Empage/Digimato/README.md

Digimato
========

This repository contains the documentation and firmware of a self-built microcontrolled digital clock.
