Empage/Digimato/latex/document.tex

\documentclass[%
	pdftex,
	oneside,		% Einseitiger Druck.
	12pt,			% Schriftgroesse
	parskip=half,	% Halbe Zeile Abstand zwischen Absätzen.
	headsepline,	% Linie nach Kopfzeile.
	%footsepline,	% Linie vor Fusszeile.
	abstracton,	    % Abstract Überschriften
	ngerman,		% Translator
]{scrartcl}

% Zeichencodierung
\usepackage[utf8]{inputenc}
\usepackage[T1]{fontenc}
 
\newcommand{\pdftitel}{Konzeption und Entwicklung einer digitalen Funk-, LED-Uhr}
\newcommand{\autor}{Tobias Schöneberger, Matthis Hauschild}
\newcommand{\arbeit}{Studienarbeit}
%falls pdftitel = titel der Arbeit
\newcommand{\titel}{\pdftitel}
%bei unterschiedlichen Titeln
%\newcommand{\titel}{In der Regel haben wir einen zweizeiligen
% Bachelorthesistitel}
\newcommand{\kurs}{TIT10AID}
\newcommand{\datumAbgabe}{Juni 2013}
\newcommand{\abgabeort}{Stuttgart}
\newcommand{\studiengang}{Angewandte Informatik}
\newcommand{\dhbw}{Stuttgart}
\newcommand{\betreuer}{Prof. Dr. Karl Friedrich Gebhardt}
\newcommand{\gutachter}{Prof. Dr. Karl Friedrich Gebhardt}
\newcommand{\zeitraum}{12 Wochen}
\newcommand{\arbeitsart}{\arbeit}

%Seitengroesse
\usepackage{fullpage} 

%Zeilenumbruch und mehr
\usepackage[activate]{microtype}

% Zeilenabstand
\usepackage[onehalfspacing]{setspace}

% Index-Erstellung
%\usepackage{makeidx}

% Lokalisierung (neue deutsche Rechtschreibung)
\usepackage[ngerman]{babel}  
 
% Anführungszeichen 
\usepackage[babel,german=quotes]{csquotes}
%\usepackage[style=swiss]{csquotes}

% Spezielle Tabellenform fuer Deckblatt
\usepackage{longtable}
\setlength{\tabcolsep}{10pt} %Abstand zwischen Spalten
\renewcommand{\arraystretch}{1.5} %Zeilenabstand

% Grafiken
\usepackage{graphicx}

%Farben
\usepackage{color}
\definecolor{sh_comment}{rgb}{0.12, 0.38, 0.18 } %adjusted, in Eclipse: {0.25, 0.42, 0.30 } = #3F6A4D
\definecolor{sh_keyword}{rgb}{0.37, 0.08, 0.25}  % #5F1441
\definecolor{sh_string}{rgb}{0.06, 0.10, 0.98} % #101AF9

%\usepackage{fancyhdr}

\usepackage{bibgerm}
\usepackage{longtable}
% für textumflossene Grafiken
\usepackage{wrapfig} 

% Fussnoten
\usepackage[hang, multiple, stable]{footmisc}

% Verschiedene Schriftarten
%\usepackage{goudysans}
\usepackage{lmodern}
%\usepackage{libertine}
%\usepackage{palatino} 

% Hurenkinder und Schusterjungen verhindern
% http://projekte.dante.de/DanteFAQ/Silbentrennung
\clubpenalty=10000
\widowpenalty=10000
\displaywidowpenalty=10000

\newcommand{\degree}{\ensuremath{^\circ}}

% Titel, Autor und Datum
\title{\titel}
\author{\autor}
\date{\datum}

% PDF Einstellungen
\usepackage[%
	pdftitle={\pdftitel},
	pdfauthor={\autor},
	pdfsubject={\arbeit},
	pdfcreator={pdflatex, LaTeX with KOMA-Script},
	pdfpagemode=UseOutlines, % Beim Oeffnen Inhaltsverzeichnis anzeigen
	pdfdisplaydoctitle=true, % Dokumenttitel statt Dateiname anzeigen.
	pdfborder={0 0 0},
	pdflang=de % Sprache des Dokuments.
]{hyperref} 

 \usepackage{listings}
 \usepackage{courier}
 \lstset{
         basicstyle=\small\ttfamily, % Standardschrift
         numbers=left,               % Ort der Zeilennummern
         numberstyle=\tiny,          % Stil der Zeilennummern
         %stepnumber=2,               % Abstand zwischen den Zeilennummern
         numbersep=5pt,              % Abstand der Nummern zum Text
         tabsize=2,                  % Groesse von Tabs
         lineskip=-2pt,
         extendedchars=true,         %
         breaklines=true,            % Zeilen werden Umgebrochen
         keywordstyle=\color{sh_keyword}\bfseries,
            frame=b,         
 %        keywordstyle=[1]\textbf,    % Stil der Keywords
 %        keywordstyle=[2]\textbf,    %
 %        keywordstyle=[3]\textbf,    %
 %        keywordstyle=[4]\textbf,   \sqrt{\sqrt{}} %
         stringstyle=\color{sh_string}\ttfamily, % Farbe der String
         commentstyle=\color{sh_comment},
         showspaces=false,           % Leerzeichen anzeigen ?
         showtabs=false,             % Tabs anzeigen ?
         xleftmargin=17pt,
         framexleftmargin=17pt,
         framexrightmargin=5pt,
         framexbottommargin=4pt,
         %backgroundcolor=\color{lightgray},
         showstringspaces=false      % Leerzeichen in Strings anzeigen ?        
 }
 \lstloadlanguages{% Check Dokumentation for further languages ...
         %[Visual]Basic
         %Pascal
         C
         %C++
         %XML
         %HTML
         %Java
 }
\usepackage{caption}
\DeclareCaptionFont{white}{\color{white}}
\DeclareCaptionFormat{listing}{\colorbox[cmyk]{0.43, 0.35, 0.35,0.01}{\parbox{\textwidth}{\hspace{15pt}#1#2#3}}}
\captionsetup[lstlisting]{format=listing,labelfont=white,textfont=white, singlelinecheck=false, margin=0pt, font={bf,footnotesize}}

\begin{document}
	\renewcommand{\figurename}{Abb.}
	% Deckblatt
	\begin{spacing}{1}
		\input{deckblatt}
	\end{spacing}
	\newpage

	% Sperrvermerk
	\renewcommand{\thepage}{\Roman{page}} 
	\setcounter{page}{1}

	% Erklärung
	\input{erklaerung}
	\newpage
	
	\tableofcontents
	\newpage 
	
	\renewcommand{\thepage}{\arabic{page}}
	\setcounter{page}{1}
	 
	\input{einleitung.tex} 
	\input{anforderungen.tex}
	\input{grundlagen.tex}
	\input{komponenten.tex}
	\input{gesamtsystem.tex}
	\input{resume.tex}
%
    \newpage
    \bibliography{Literatur/stud}
    \bibliographystyle{geralpha}
%
    \newpage
    \appendix
    \input{appendix.tex}
\end{document}    
%
% Einleitung
% -Motivation
% -Umfang
% Anforderungen
% Technische Grundlagen
% - DCF77
% - LED Matrix
% - PWM
% Betrachtung der Komponenten
% - Mikrocontroller
% - DCF77 Empfangsmodul
% - LED Matrix
% - Helligkeitssensor
% - Temperatursensor
% - Infrarotempfänger
% Betrachtung des Gesamtsystems
% - Gehäuse
% Zusammenfassung
% -Evaluation
% -Weiterentwicklungsmoeglichkeiten
% -Fazit
% - Kosten

% NANANNANAN Matt\cite{cite1} Tobi\cite{cite2}
% 
% Uberblick gesamtsystem
% - Anfordungen an die Uhr
%  - elementar
%   - Zeitempfang
%   - Anzeigen der Zeit
%  - erweitert
%   - Datumsanzeige
%   - Wecker
%   - Helligkeitsanpassung
%   - geschaltet steckdose
%   - infrarotempfang
%   - temperatursensor
%   - Updatefaehigkeit
%   - Uhrzeit einstellen
%   
% -Betrachtung der einzelenen Elemente
%  - minimal
%  - erweitert
% -Display (LED Matrix)
%  - Prinzip
%  - Moeglichkeiten zur umsetzung
%  - vor und nachteile der Moeglichen
% - Zeitempfang
%  - DCF77 vs. GPS vs. England sender
%    GPS genauer aber teuerer, indoorempfang gut?
%  - DCF77 im Detail
%  - vergleich von verschieden empfangsmodulen
%  - vergleich von verschieden methoden zur auswertung
% - Mikrocontroller
%  - Warum mikrocontroller? und nicht fertiger baustein?
%  - ATmega vs. z.B. Cortex-m3 vs 
%  - Pro:
%   - einfache Programmierung
%   - guenstig
%   - einzeln verfuegbar
%   - DIP
%   - geringer stromverbrauch
%   - viele IO Pins
%   - viel verfuegbarer code
% 
%  
% - Zusatzmodule
%  - Temperatur
%   1 wire bus sensor um pins zu sparen und adc muss dann nicht umgeschaltet werden
%  - Helligkeit und dimmen
%   Lichtabhaeniger Widerstand an A/D Wandler und LED PWM
%  - Wecker
%   Lautsprecher + Weckzeit im EEPROM
%  - Steckdosenmodul
%   Relais mit verstaerkendem transistor/fet
%  - Infrarotmodul
%   Empfang und dekodierung von Infrarotsignalen von Fernbedienungen zur einstellung der Weckzeit
%  -
