Empage/Digimato/latex/deckblatt.tex

\begin{titlepage}
	\begin{longtable}{p{.4\textwidth} p{.4\textwidth}}
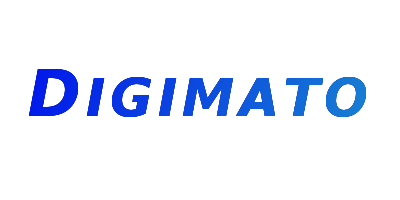
[picture p24: latex/images/logo.png]
	  {} & 
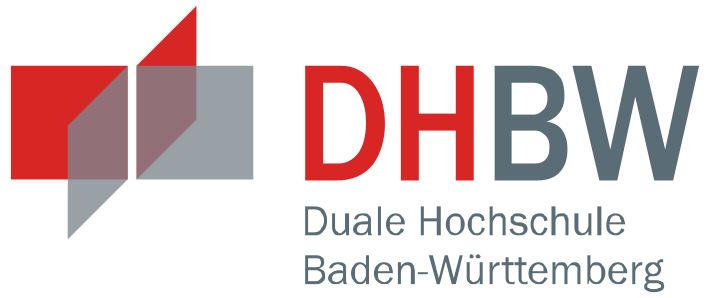
[picture p25: latex/images/dhbw.png]
	  {}
	\end{longtable}
	\enlargethispage{25mm}
	\begin{center}
	  \vspace*{18mm}	{\LARGE\bf \titel }\\
	  \vspace*{18mm}	{\large\bf \arbeit}\\
	  \vspace*{18mm}	\studiengang\\
	  \vspace*{3mm} 	an der Dualen Hochschule Baden-Württemberg \dhbw\\
	  \vspace*{18mm}	von\\
	  \vspace*{3mm} 	{\large\bf \autor}\\
	  \vspace*{18mm}	\datumAbgabe\\
	\end{center}
	\vfill
	\begin{spacing}{1.2}
	\begin{tabbing}
		mmmmmmmmmmmmmmmmmmmmmmmmmm     \= \kill
		\textbf{Abgabe}  \>  10.06.2013\\
		\textbf{Kurs}  				   \>  \kurs\\
		\textbf{Betreuer}              \>  \betreuer\\
		\textbf{Gutachter}             \>  \gutachter
	\end{tabbing}
	\end{spacing}
\end{titlepage}
