Empage/Digimato/latex/erklaerung.tex

\thispagestyle{empty}

\section*{Erklärung}
% http://www.se.dhbw-mannheim.de/fileadmin/ms/wi/dl_swm/dhbw-ma-wi-organisation-bewertung-bachelorarbeit-v2-00.pdf
\vspace*{2em}

Wir erklären hiermit ehrenwörtlich: \\
\begin{enumerate}
\item dass wir unsere {\arbeitsart} mit dem Thema
{\itshape \titel } ohne fremde Hilfe angefertigt haben;
\item dass wir die Übernahme wörtlicher Zitate aus der Literatur sowie die
Verwendung der Gedanken anderer Autoren an den entsprechenden Stellen innerhalb
der Arbeit gekennzeichnet haben;
\item dass wir unsere {\arbeitsart} bei keiner anderen Prüfung vorgelegt habe;
\item dass die eingereichte elektronische Fassung exakt mit der eingereichten schriftlichen Fassung
übereinstimmt.
\end{enumerate}

Wir sind uns bewusst, dass eine falsche Erklärung rechtliche Folgen haben wird.

\vspace{3em}

\abgabeort, \datumAbgabe
\vspace{6em}

\begin{tabular}[h]{p{5cm} p{2cm} p{5cm}}
  \hline
	Matthis Hauschild & &Tobias Schöneberger \\
\end{tabular}
