Empage/Digimato/latex/schaltplan 2.pptx

+5V

Reihe 1..8

1

Reihe 9..16

R 17

2

TPIC 6B595

8

TPIC 6B595

8

SER_IN

ATmega
32

7

SER_IN

SER_OUT

SER_OUT

Spalte 1..7

2

R_CK + SR_CK
