Empage/Digimato/doc/AVR pinbelegung neu ohne IR.pdf

Tabelle1

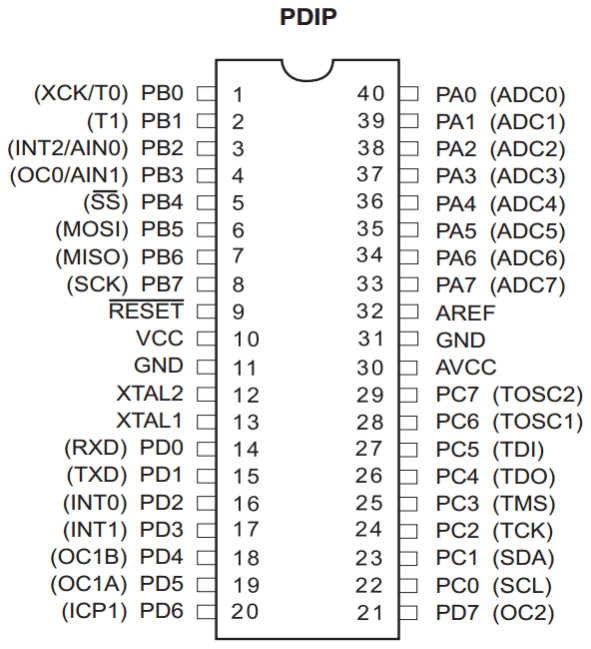
[picture p26: figure]

14,745600 MHz

Debug Pin | PB0 | PA0
Debug LED | PB1 | PA1
PB2 | PA2 | Taster3 (rot)
PB3 | PA3 | Taster4 (rot)
SR: RCK | PA4
SR: SER_IN | PB5(MOSI) | PA5
PB6(MISO) | PA6
SR: SRCK | PB7(SCK) | PA7
TPIC6B595N | RESET | AREF
VCC | GND
GND | AVCC
XTAL2 | PC7
XTAL1 | PC6
MOSF(1) | PD0 | PC5
MOSF(2) | PD1 | PC4
MOSF(3) | PD2 | PC3
MOSF(4) | PD3 | PC2
MOSF(5) | PD4 | PC1
MOSF(6) | PD5 | PC0
MOSF(7) | PD6 | PD7

Taster1 (schwarz)
Taster2 (schwarz)
DCF77-Modul
PB4(SS) | Taster5 (blau) Taster6 (blau)
Schieberegister | Lichtsensor
Quarz | Lagesensor 0
Quarz | Lagesensor 1
| Lagesensor 2
| Lagesensor 3

Lautsprecher
17 Reihe Led
