Empage/Digimato/doc/fresh images/unterseite_drahtgitter.jpg

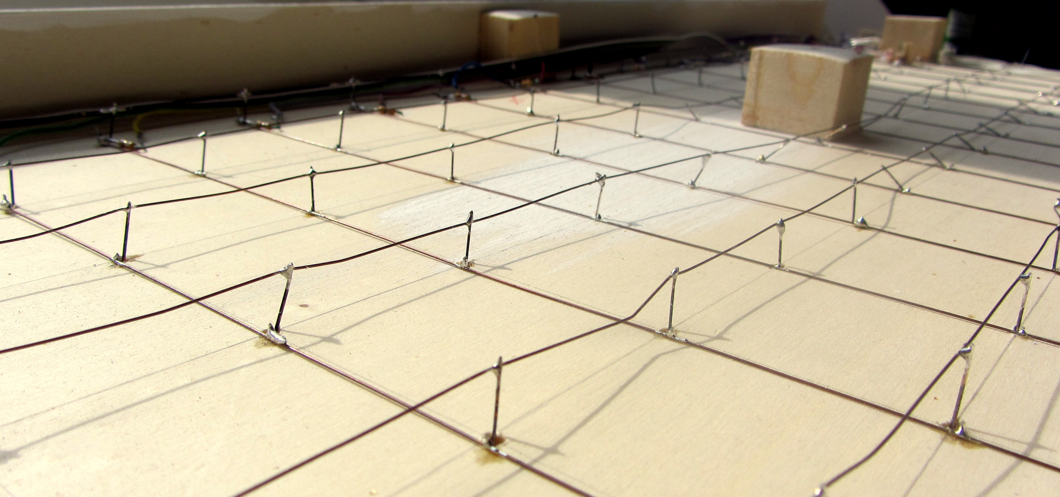
doc/fresh images/unterseite_drahtgitter.jpg
