Empage/Digimato/doc/raw images/2012-11-22 17.52.00.jpg

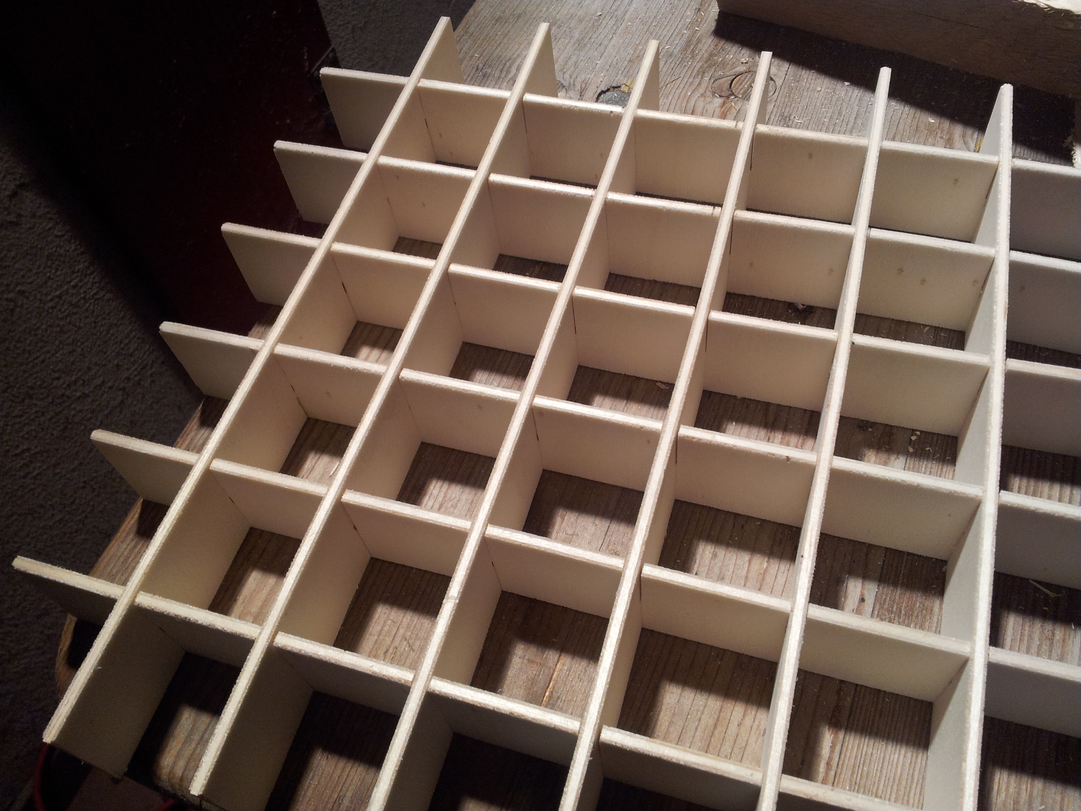
doc/raw images/2012-11-22 17.52.00.jpg
