Empage/Digimato/doc/raw images/2012-11-29 11.09.01.jpg

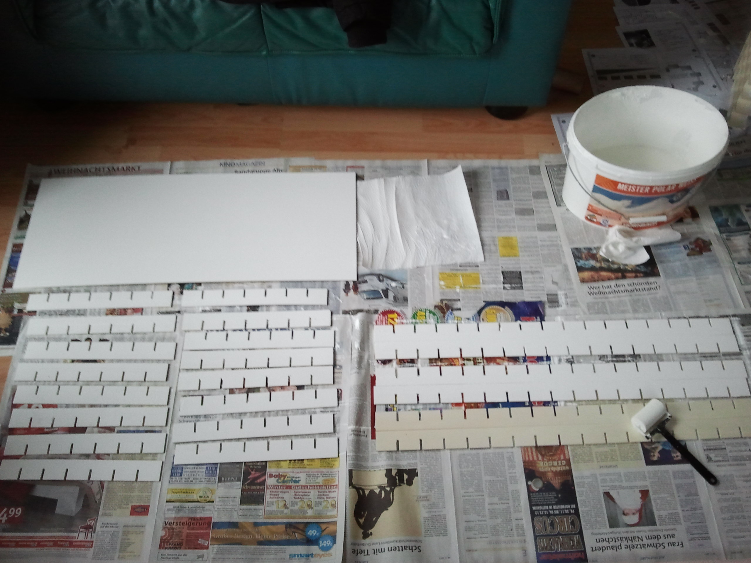
doc/raw images/2012-11-29 11.09.01.jpg
