Empage/Digimato/doc/raw images/2013-01-19 23.54.27.jpg

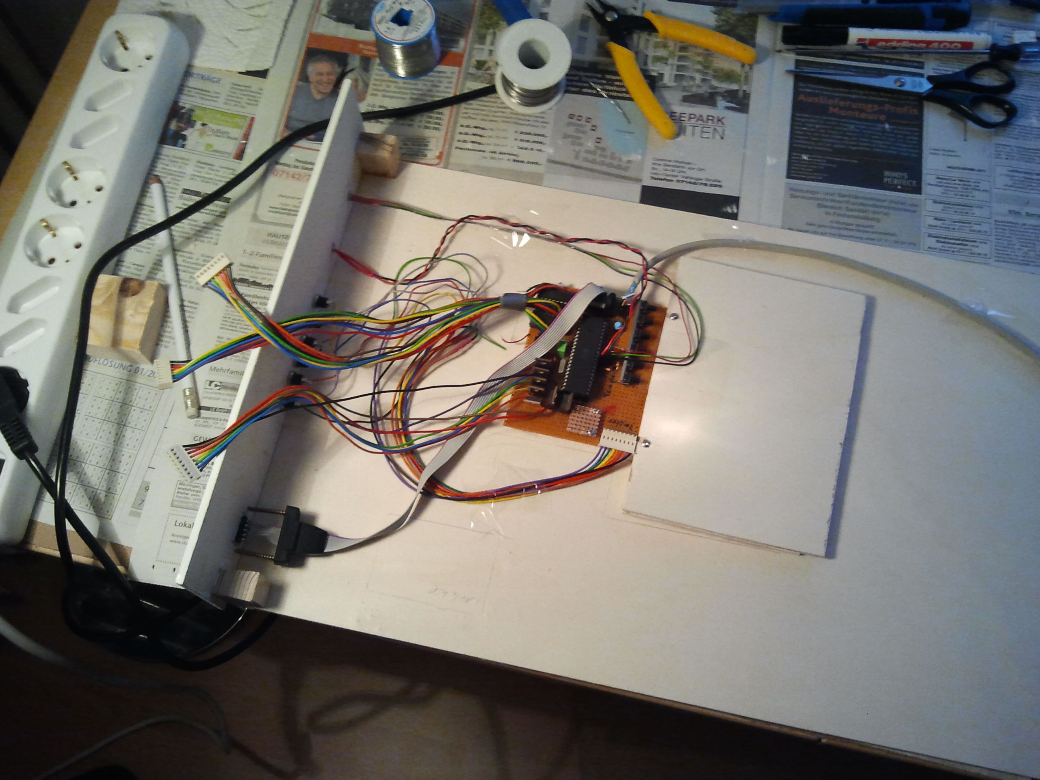
doc/raw images/2013-01-19 23.54.27.jpg
