Empage/Digimato/doc/raw images/2013-01-19 23.55.18.jpg

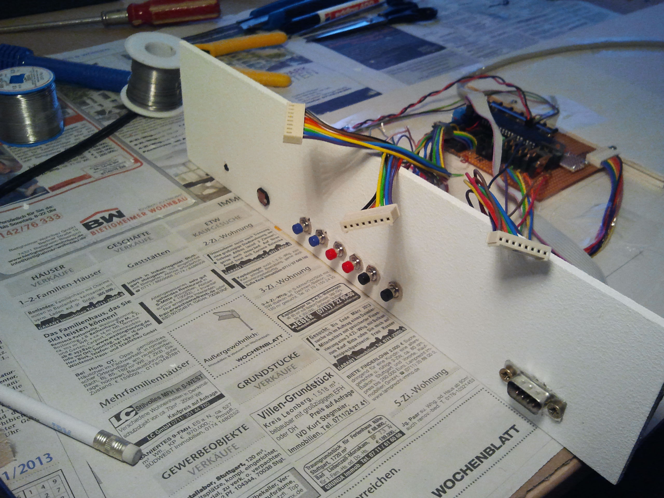
doc/raw images/2013-01-19 23.55.18.jpg
