Empage/Digimato/doc/raw images/2013-01-20 00.01.10.jpg

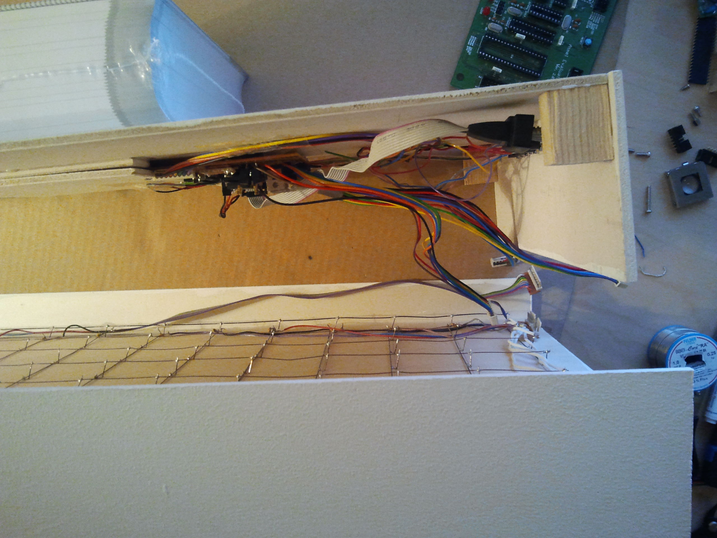
doc/raw images/2013-01-20 00.01.10.jpg
