Empage/Digimato/doc/raw images/2013-01-20 00.05.20.jpg

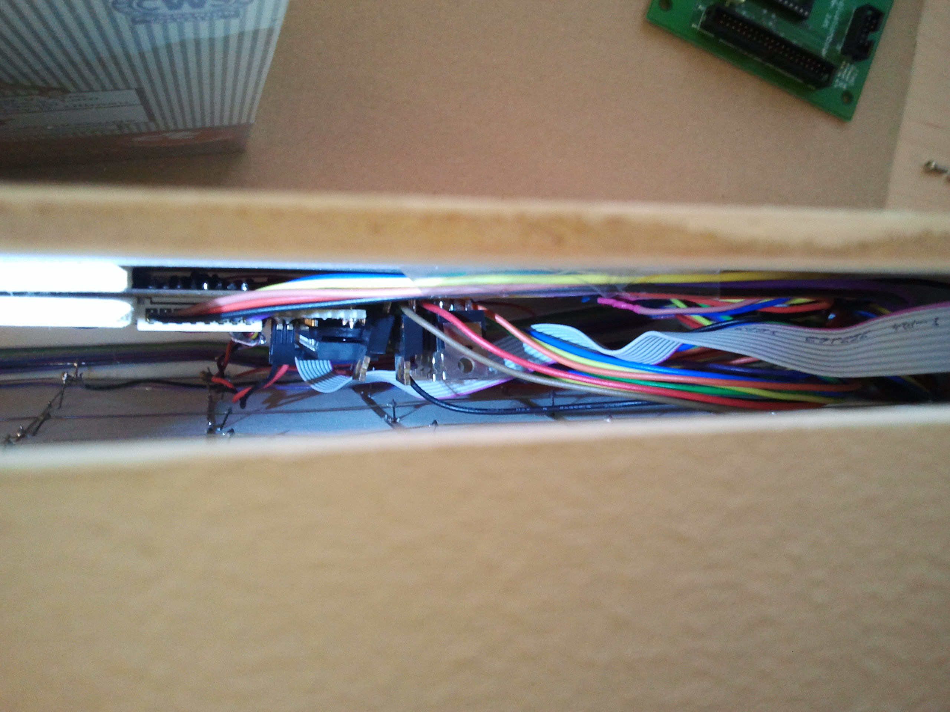
doc/raw images/2013-01-20 00.05.20.jpg
