Empage/Digimato/doc/raw images/2013-01-20 00.16.05.jpg

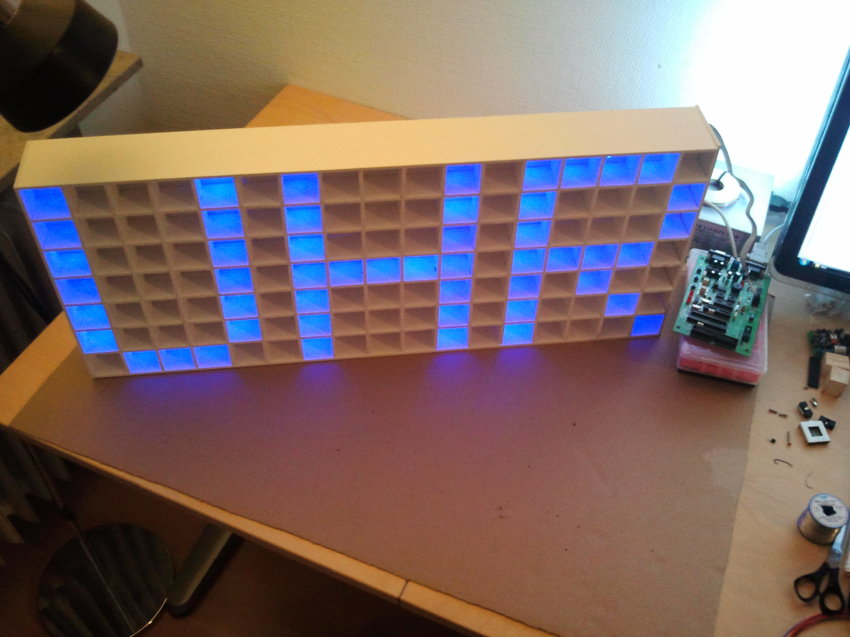
doc/raw images/2013-01-20 00.16.05.jpg
