Empage/Digimato/doc/raw images/IMG_1525.JPG

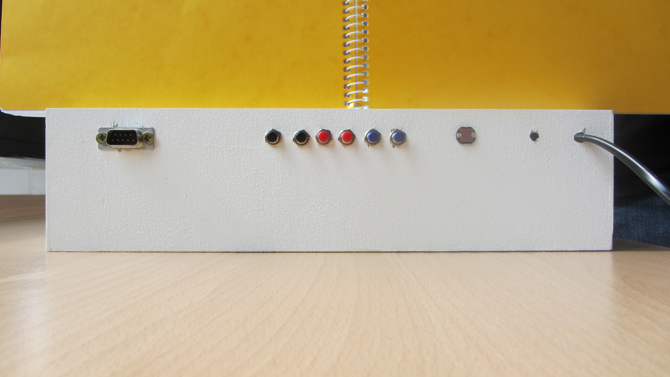
doc/raw images/IMG_1525.JPG
