Empage/Digimato/doc/raw images/IMG_1526.JPG

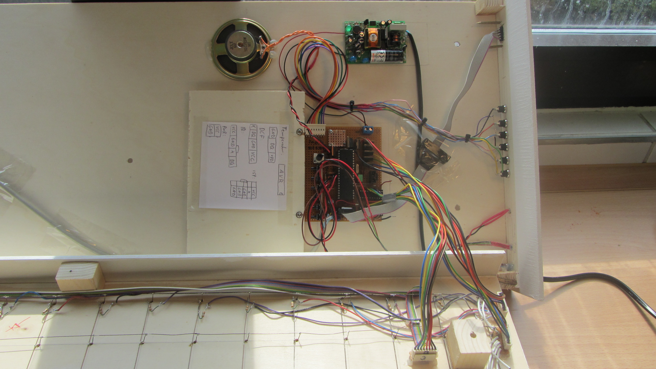
doc/raw images/IMG_1526.JPG
