Empage/Digimato/doc/raw images/IMG_1527.JPG

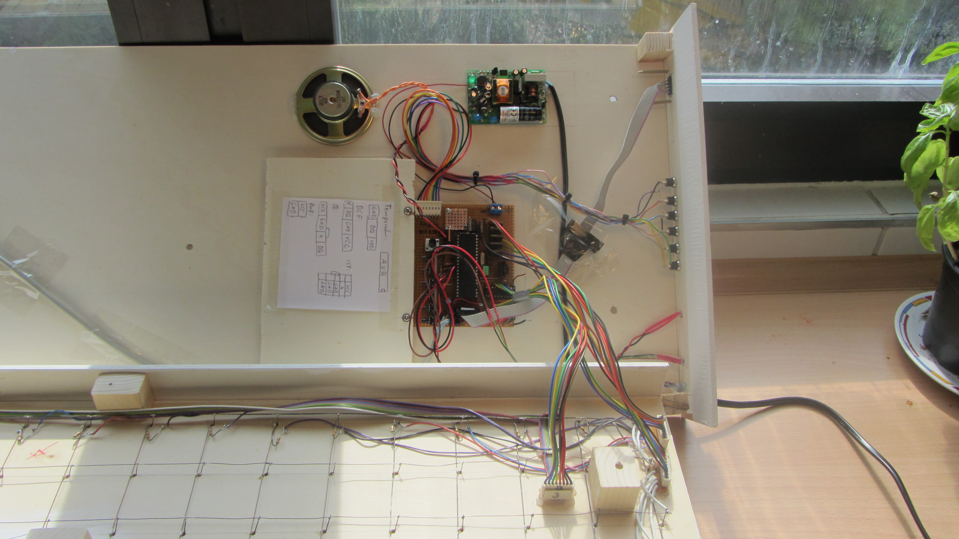
doc/raw images/IMG_1527.JPG
