Empage/Digimato/doc/raw images/IMG_1528.JPG

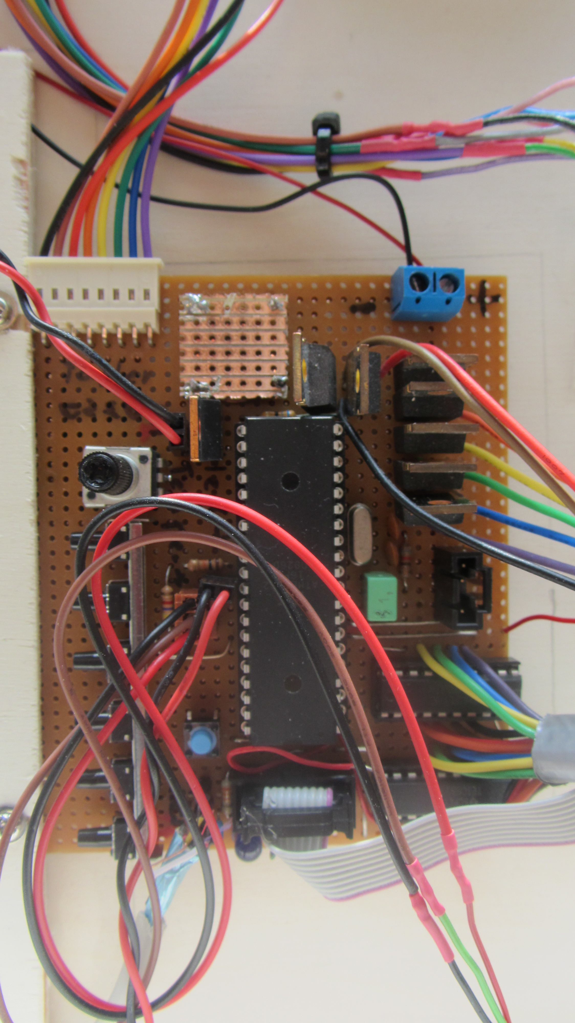
doc/raw images/IMG_1528.JPG
