Empage/Digimato/doc/raw images/IMG_1529.JPG

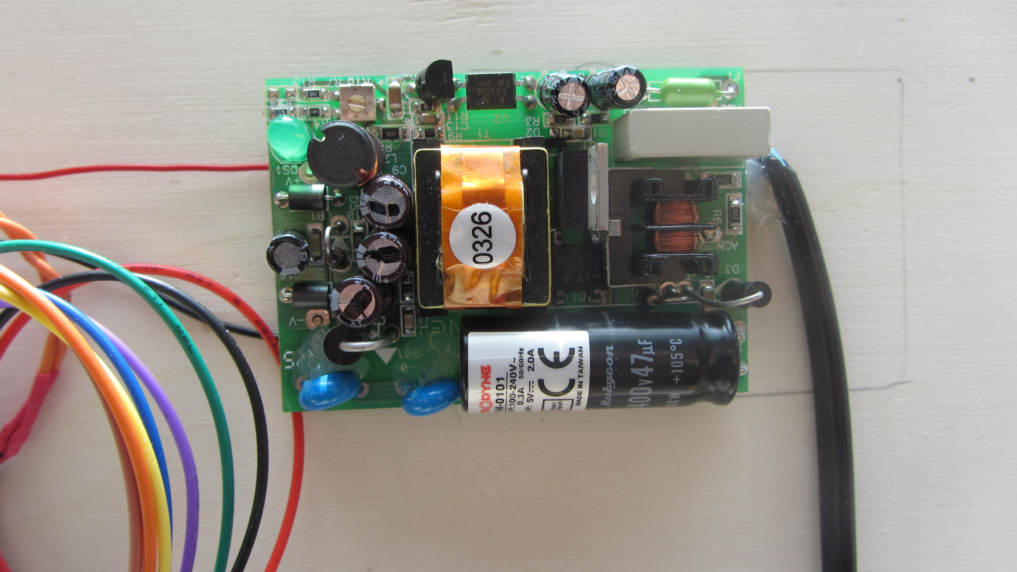
doc/raw images/IMG_1529.JPG
