Empage/Digimato/doc/raw images/IMG_1531.JPG

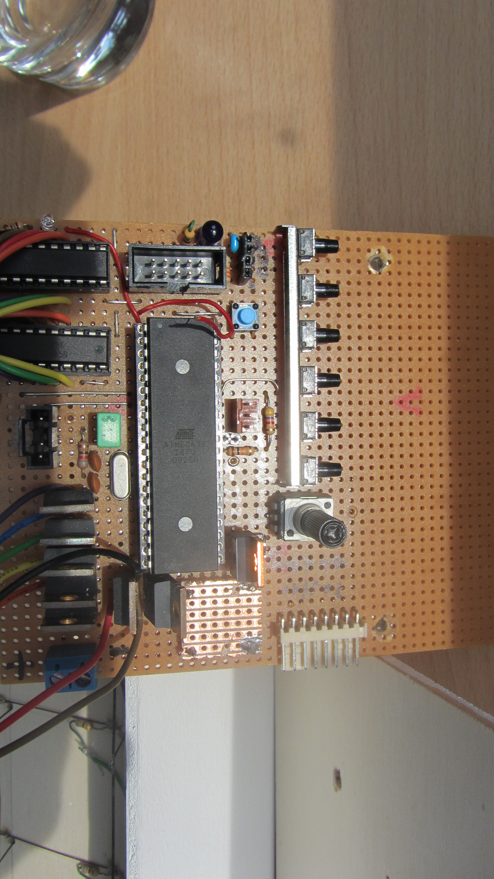
doc/raw images/IMG_1531.JPG
