Empage/Digimato/doc/raw images/IMG_1532.JPG

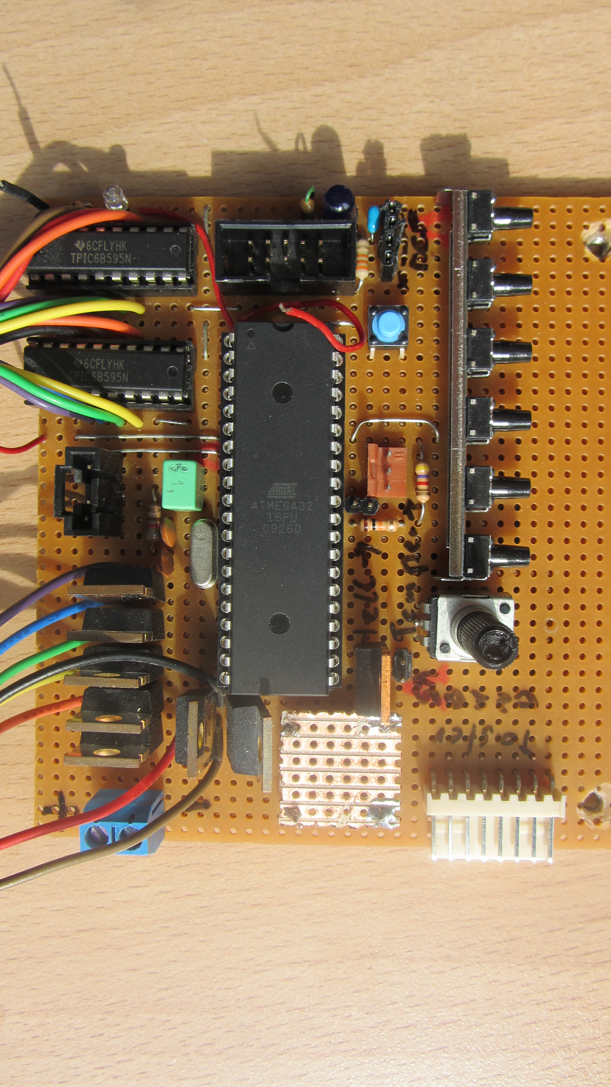
doc/raw images/IMG_1532.JPG
