Empage/Digimato/doc/raw images/IMG_1533.JPG

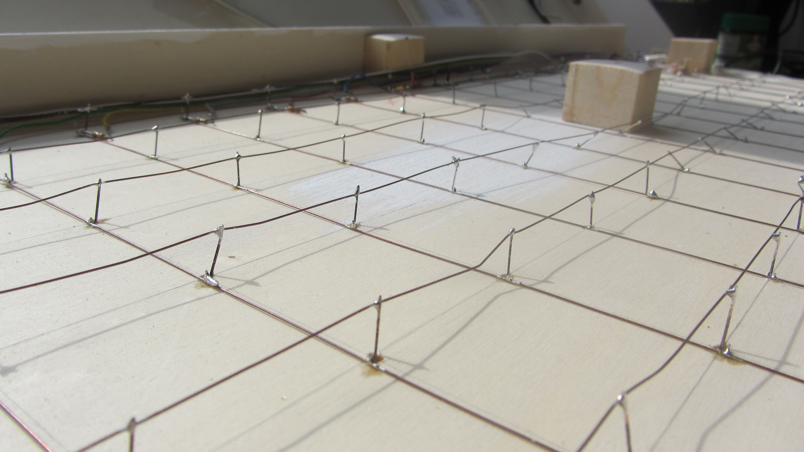
doc/raw images/IMG_1533.JPG
