Empage/Digimato/doc/raw images/IMG_1534.JPG

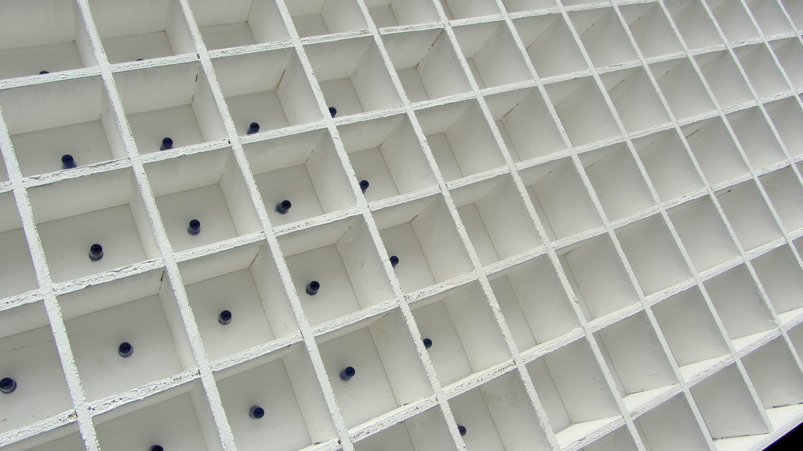
doc/raw images/IMG_1534.JPG
