Empage/Digimato/doc/raw images/IMG_1535.JPG

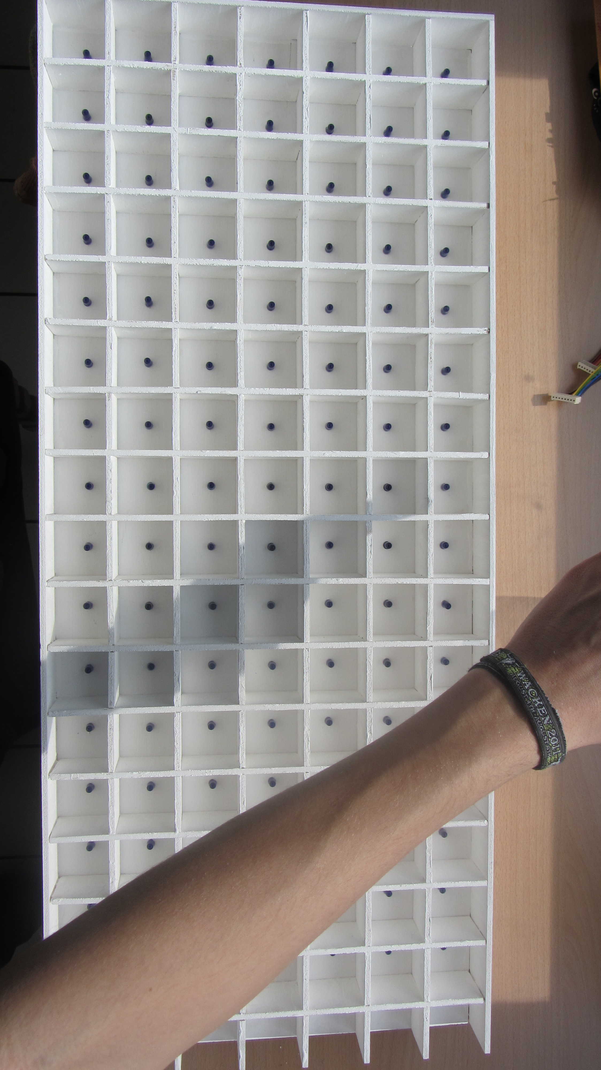
doc/raw images/IMG_1535.JPG
