Empage/Digimato/doc/raw images/IMG_1536.JPG

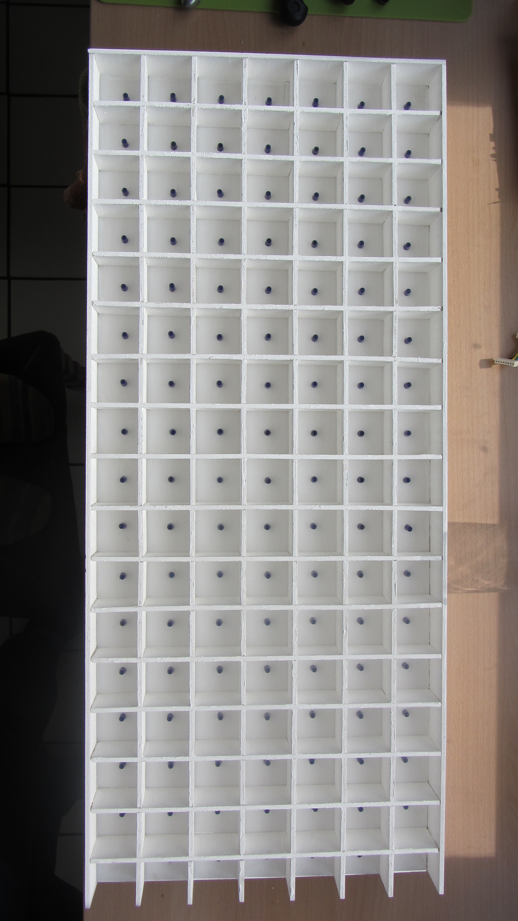
doc/raw images/IMG_1536.JPG
