Empage/Digimato/doc/raw images/IMG_1537.JPG

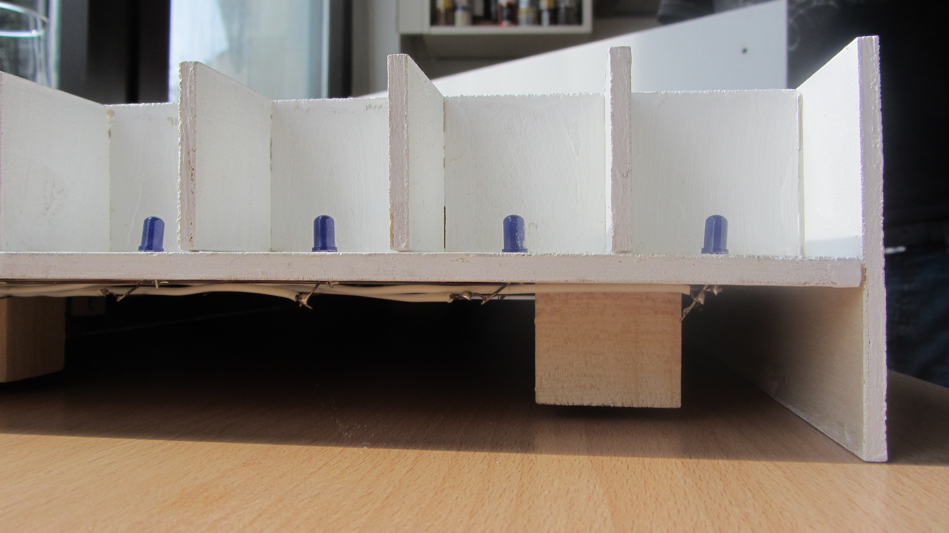
doc/raw images/IMG_1537.JPG
