Empage/Digimato/doc/raw images/IMG_1538.JPG

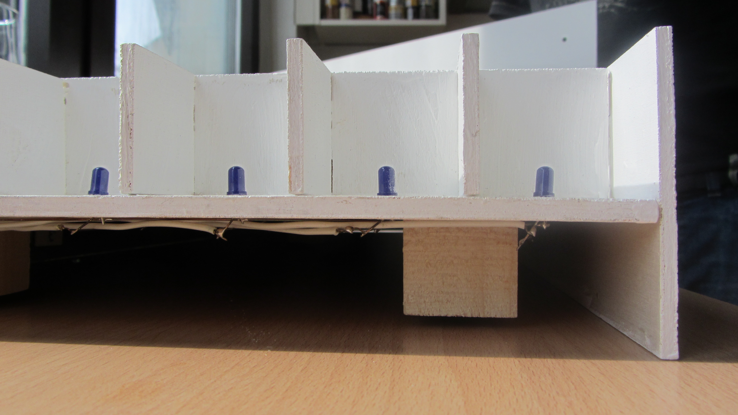
doc/raw images/IMG_1538.JPG
