Empage/Digimato/doc/raw images/IMG_1539.JPG

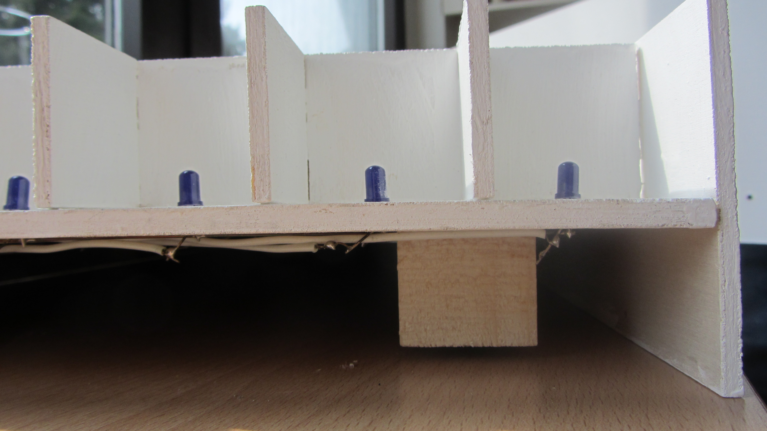
doc/raw images/IMG_1539.JPG
