Empage/Digimato/doc/raw images/IMG_1540.JPG

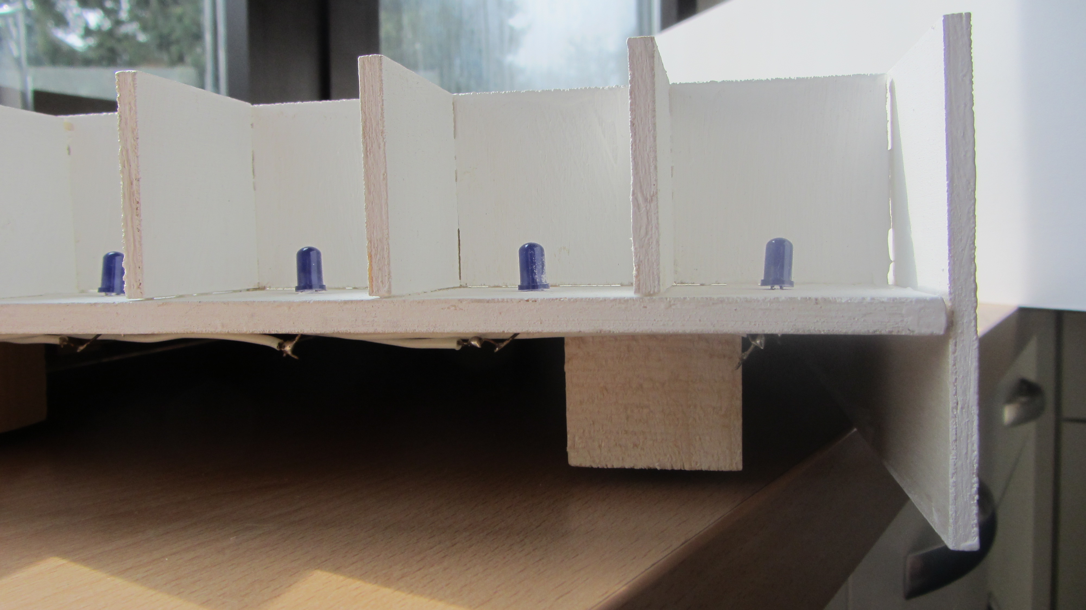
doc/raw images/IMG_1540.JPG
