Empage/Digimato/latex/skizzen/AtMega.png

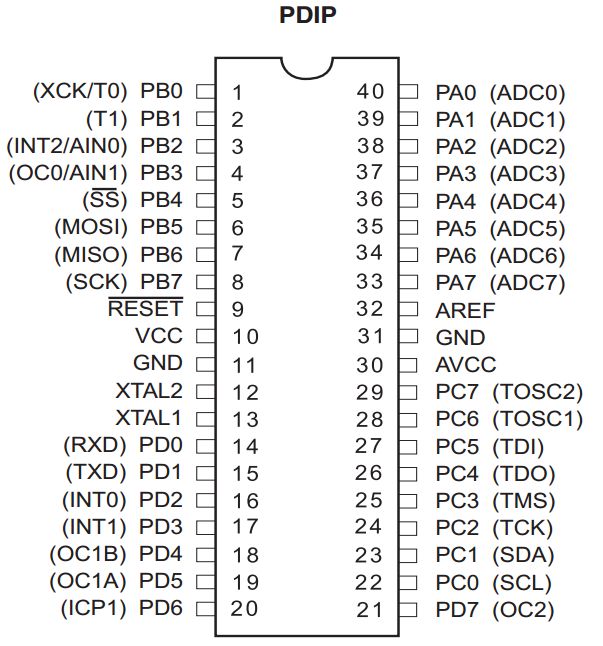
latex/skizzen/AtMega.png
