Empage/Digimato/latex/skizzen/dcf77kodierung.png

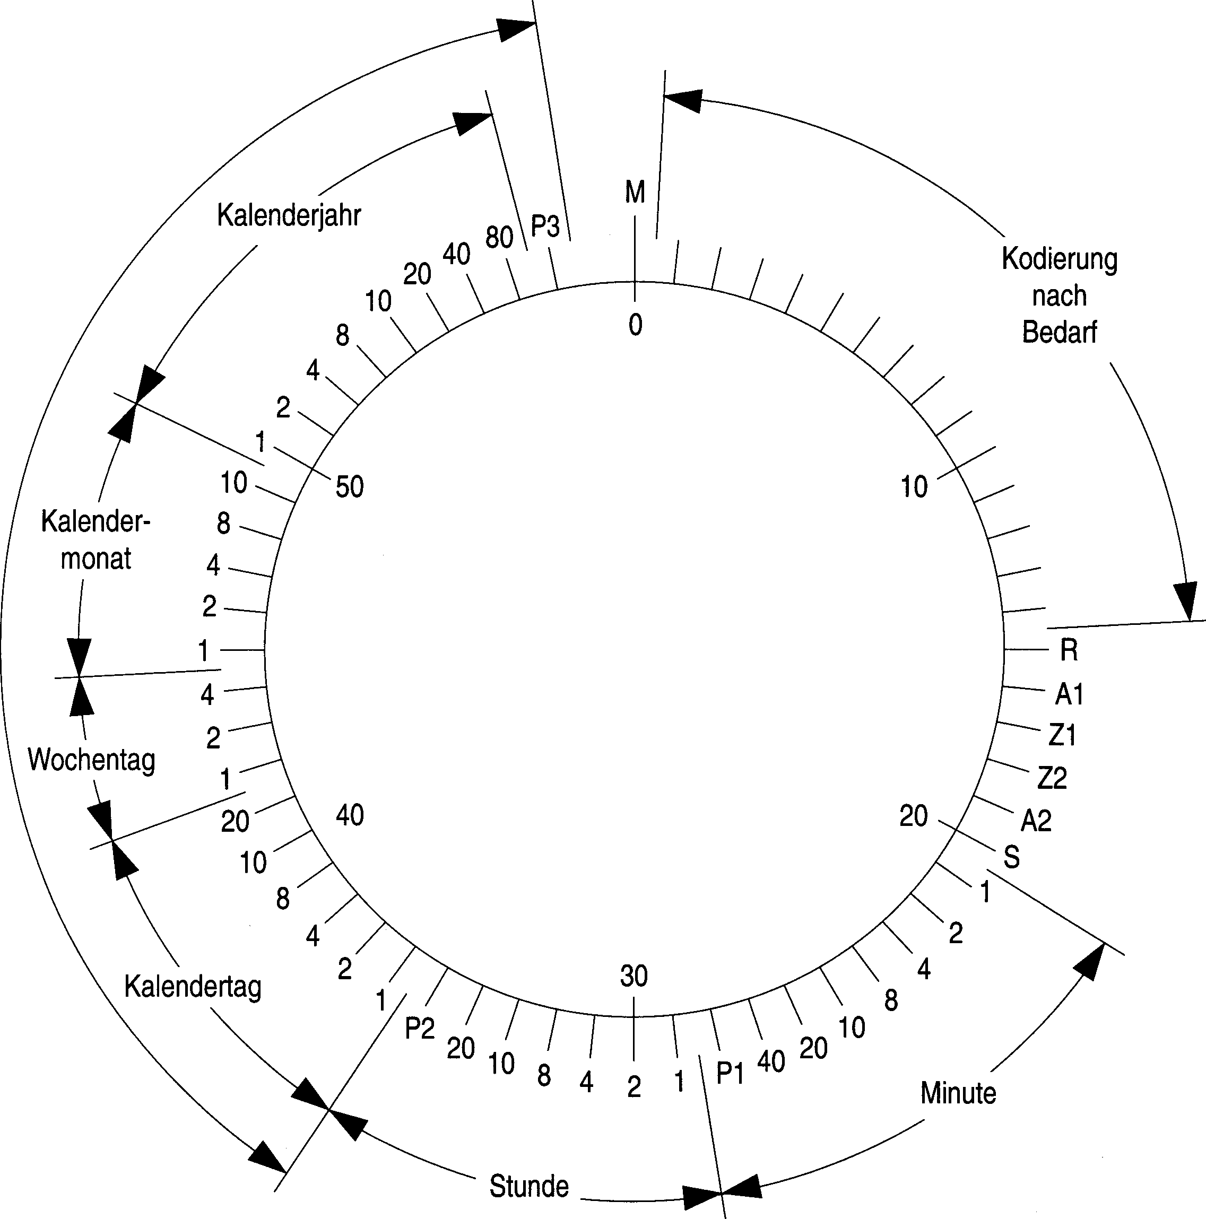
latex/skizzen/dcf77kodierung.png
