Empage/Digimato/latex/skizzen/lage sensor.png

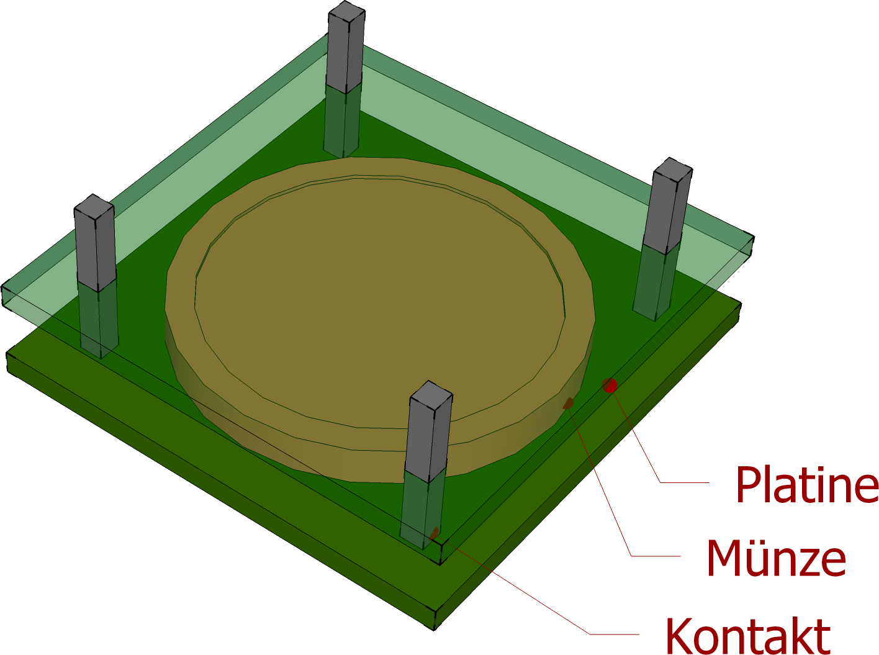
latex/skizzen/lage sensor.png
