Empage/Digimato/latex/skizzen/schaltplan 2.png

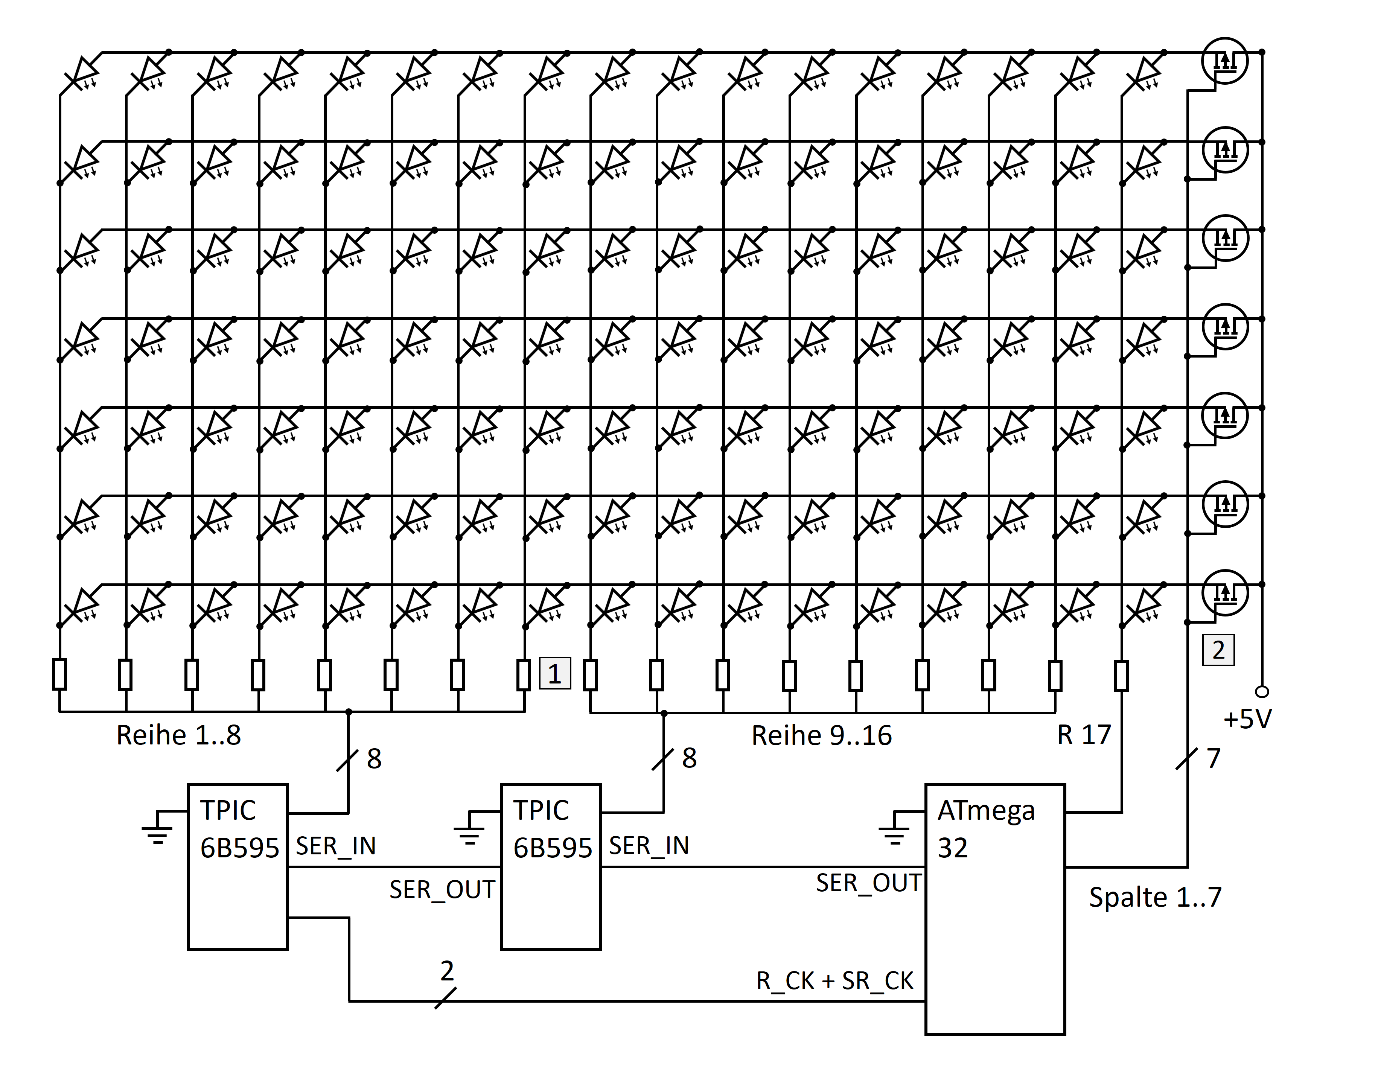
latex/skizzen/schaltplan 2.png
