Empage/Digimato/latex/skizzen/SpannungteilerAllgemein.png

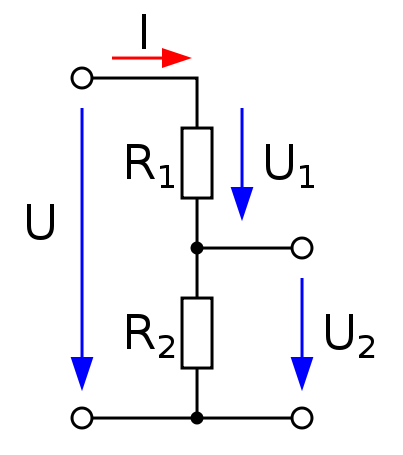
latex/skizzen/SpannungteilerAllgemein.png
