Empage/Digimato/Matthis Uhr/Steckerbelegung.png

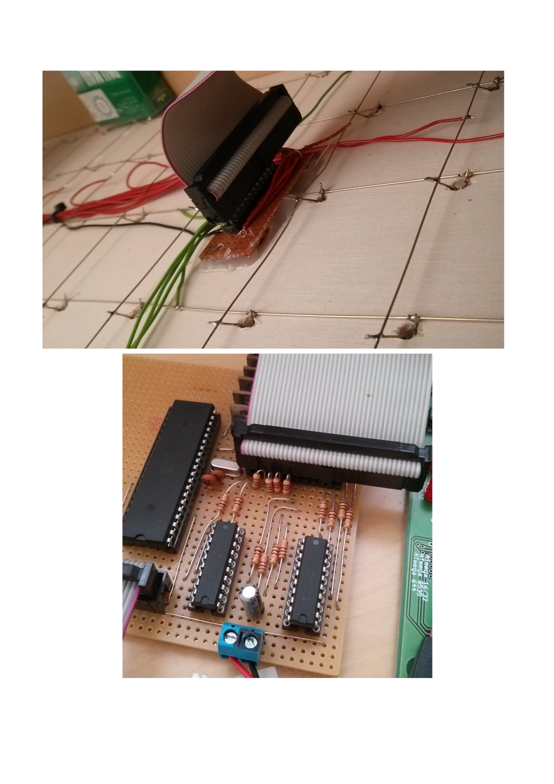
Matthis Uhr/Steckerbelegung.png
