Empage/Digimato/(list of files, cad)

Other CAD files:
doc/3d sketchup models/Digimato full size.skp
doc/3d sketchup models/Kloetz mit Mutter.skp
doc/3d sketchup models/coin lage sensor.skp
