Empage/Digimato/(list of files, drawings)

Other design files:
doc/helligkeitsensor_ tinycad.dsn
doc/temperatursensor_tinycad.dsn
