Empage/Digimato/additionalSoftware/IRMP Code/SVN Version/main.c

/*---------------------------------------------------------------------------------------------------------------------------------------------------
 * main.c - demo main module to test irmp decoder
 *
 * Copyright (c) 2009-2011 Frank Meyer - frank(at)fli4l.de
 *
 * $Id: main.c,v 1.10 2011/09/08 13:22:16 fm Exp $
 *
 * ATMEGA88 @ 8 MHz
 *
 * Fuses: lfuse: 0xE2 hfuse: 0xDC efuse: 0xF9
 *
 * This program is free software; you can redistribute it and/or modify
 * it under the terms of the GNU General Public License as published by
 * the Free Software Foundation; either version 2 of the License, or
 * (at your option) any later version.
 *---------------------------------------------------------------------------------------------------------------------------------------------------
 */

#include <inttypes.h>
#include <avr/io.h>
#include <util/delay.h>
#include <avr/pgmspace.h>
#include <avr/interrupt.h>

#include "irmpconfig.h"
#include "irmp.h"
#include "irmp.c"

#ifndef F_CPU
#error F_CPU unkown
#endif

void timer1_init (void)
{
#if defined (__AVR_ATtiny45__) || defined (__AVR_ATtiny85__)                // ATtiny45 / ATtiny85:
    OCR1A   =  (F_CPU / F_INTERRUPTS / 4) - 1;                              // compare value: 1/15000 of CPU frequency, presc = 4
    TCCR1   = (1 << CTC1) | (1 << CS11) | (1 << CS10);                      // switch CTC Mode on, set prescaler to 4
#else                                                                       // ATmegaXX:
    OCR1A   =  (F_CPU / F_INTERRUPTS) - 1;                                  // compare value: 1/15000 of CPU frequency
    TCCR1B  = (1 << WGM12) | (1 << CS10);                                   // switch CTC Mode on, set prescaler to 1
#endif

#ifdef TIMSK1
    TIMSK1  = 1 << OCIE1A;                                                  // OCIE1A: Interrupt by timer compare
#else
    TIMSK   = 1 << OCIE1A;                                                  // OCIE1A: Interrupt by timer compare
#endif
}

/*---------------------------------------------------------------------------------------------------------------------------------------------------
 * Timer 1 output compare A interrupt service routine, called every 1/15000 sec
 *---------------------------------------------------------------------------------------------------------------------------------------------------
 */
#ifdef TIM1_COMPA_vect                                                      // ATtiny84
ISR(TIM1_COMPA_vect)
#else
ISR(TIMER1_COMPA_vect)
#endif
{
  (void) irmp_ISR();                                                        // call irmp ISR
  // call other timer interrupt routines...
}


int main (void)
{
    IRMP_DATA irmp_data;
	
	
	DDRD=0xFF;
	DDRA=0xFF;
	
	PORTA = 0b11110000;

    irmp_init();                                                            // initialize irmp
    timer1_init();                                                          // initialize timer 1
    sei ();                                                                 // enable interrupts

    for (;;)
    {
		PORTD = 0b01110111;
        if (irmp_get_data (&irmp_data))
        {
			PORTD = 0b11111111;
			_delay_ms(500);
            // ir signal decoded, do something here...
            // irmp_data.protocol is the protocol, see irmp.h
            // irmp_data.address is the address/manufacturer code of ir sender
            // irmp_data.command is the command code
            // irmp_protocol_names[irmp_data.protocol] is the protocol name (if enabled, see irmpconfig.h)
        }
    }
}
