Empage/Digimato/src/Digimato/main.h

/*
 * main.h
 *
 *  Created on: Nov 26, 2012
 *      Author: matthis
 */

#ifndef MAIN_H_
#define MAIN_H_

#include "globals.h"

void running_letters(char* str, byte time);
void running_letters_simple(char* str);

#endif /* MAIN_H_ */
