Empage/Digimato/src/Digimato/thermometer.h

/*
 * thermometer.h
 *
 *  Created on: Nov 30, 2012
 *      Author: matthis
 */

#ifndef THERMOMETER_H_
#define THERMOMETER_H_

void therm_initiate_temperature_read();
void therm_get_temperature(char *buffer);

#endif /* THERMOMETER_H_ */
