Empage/Digimato/(commit log)

2012-11-10 added all needed files
    [AVR pinbelegung.ods]
2012-11-12 IRMP 1-wire Small-Fonts added
2012-11-12 fixed brighness of row 16
    [main.c]
2012-11-12 Small changes
    [AVR pinbelegung.ods]
2012-11-12 added timer2 init
2012-11-14 inserted Conrad DCF77 pin
    [AVR pinbelegung.ods]
2012-11-29 Added 1 wire Thermo Datasheet
2012-11-30 First try of temperature reading
2012-11-30 Started temperature debugging
    [AVR pinbelegung.ods]
2012-12-02 Fixed thermometer, neg temperatures not tested yet
    [main.c, thermometer.c]
2013-01-13 DCF Uhrzeitempfang aktiv und funktionierend
    [AVR pinbelegung.ods]
2013-01-20 updated Pinbelegung
    [AVR pinbelegung.ods]
2013-01-20 Strukturierung des Codes
2013-01-21 Switch to 16-bit timer1
    [AVR pinbelegung.ods]
2013-02-02 running letters flackern behoben
    [globals.c, globals.h, main.c]
2013-02-02 dynamisches Temperaturmessen hinzugefuegt
    Temperatur kann jetzt ohne Unterbrechung gemessen werden.
    Leider flackert es dadaurch ganz leicht, das muss noch in den Griff
    bekommen werden
2013-02-03 Aufgeraeumt und nun DCF77 Debug
2013-02-03 Temp, Helligkeit und Ticking laeuft. DC77 nicht
2013-02-04 Added Button Support
2013-02-12 Updated Pinbelegung (Lautsprecher, Lagesensor)
    [AVR pinbelegung.ods]
2013-02-12 Fixed two major bugs: DCF and LED glimming
    [conrad_dcf.c, globals.h, main.c]
2013-02-18 Erster Versuch Conrad mit Timer2 (not working yet)
    [conrad_dcf.c, conrad_dcf.h, globals.c, globals.h, main.c]
2013-02-19 Alles läuft außer Lagesensor und Alarm
2013-02-25 Fixed delay_ms use. Neuer Compiler verlangt define
    [globals.h]
2013-02-25 Documentation housing update
2013-03-24 Latex Zeug
    [AVR pinbelegung neu ohne IR.ods, helligkeitsensor_ tinycad.dsn, temperatursensor_tinycad.dsn]
2013-03-24 started temperature sensor
2013-05-26 Logo Prototype
2013-05-26 PWM started
2013-05-26 Bild der Anschluesse hinzugefuegt
2013-05-28 Anforderungen hinzugefuegt
    Es fehlen noch Wecker, Infrarot und Stecker
2013-05-30 Software LEDs Matrix
2013-06-03 Korrekturlesen und Bilder hinzugefuegt
2013-06-03 lagesensor, mutterklotz, 3d ,odels, Skizzen
    [Digimato full size.skp, Kloetz mit Mutter.skp, coin lage sensor.skp]
2013-06-05 Sourcecode appended
    [AVR pinbelegung neu ohne IR.ods]
2015-03-05 stuff for Matthis Uhr
    [AVR pinbelegung neu ohne IR.ods]
2015-03-05 added new pin layout stuff
    [AVR pinbelegung neu ohne IR.ods]
2015-04-17 steckerbelegung matthis, code improvement
    [AVR pinbelegung neu ohne IR.ods]
2015-05-26 changed temperature display and brightness measurement
2015-06-04 added brightness view
    the autobrightness button now changes the view from time to brightness
    values and back (not tested yet).
    Furhtermore, translated the german comments in globals.c into english
2015-06-05 simplified button debouncing
2015-06-22 faster button reaction due to time update
2015-07-01 DCF measurement without PWM, new brightness values
    The DCF receiver only works without the LED matrix PWM due to too strong
    pulses. Receive time only once a night while the LED matrix is
    deactivated.
    New Brightness values to match Matthis' photoresistor.
2015-07-03 Added aborting DCF measurement
    after 1 hour of unsuccessful try of receiving the time. Also fixed
    displaying the date string by pressing button 2
    [globals.c, main.c]
2015-07-03 Added pendingButtonEvent to remove a bug
    This prevents flickering of the LEDs due to a false usage of timer0
    interrupts
    [conrad_dcf.c, conrad_dcf.h, globals.c, globals.h, main.c]
